ece3400team11/ece3400team11.github.io/_labs/milestone1/milestone1.md

---
layout: subpage
title:  "Milestone1"
---

# Milestone 1

Introduction

## Task 1 - Setting up the Line Sensors:

Demo:

## Task 2 - Following a line autonomously:

Demo:

## Task 3 - Traversing the Grid in a Figure Eight Pattern:

Demo:

## Bloopers :sweat_smile:
