ece3400team11/ece3400team11.github.io/_labs/lab2/images/6khztriangle.png

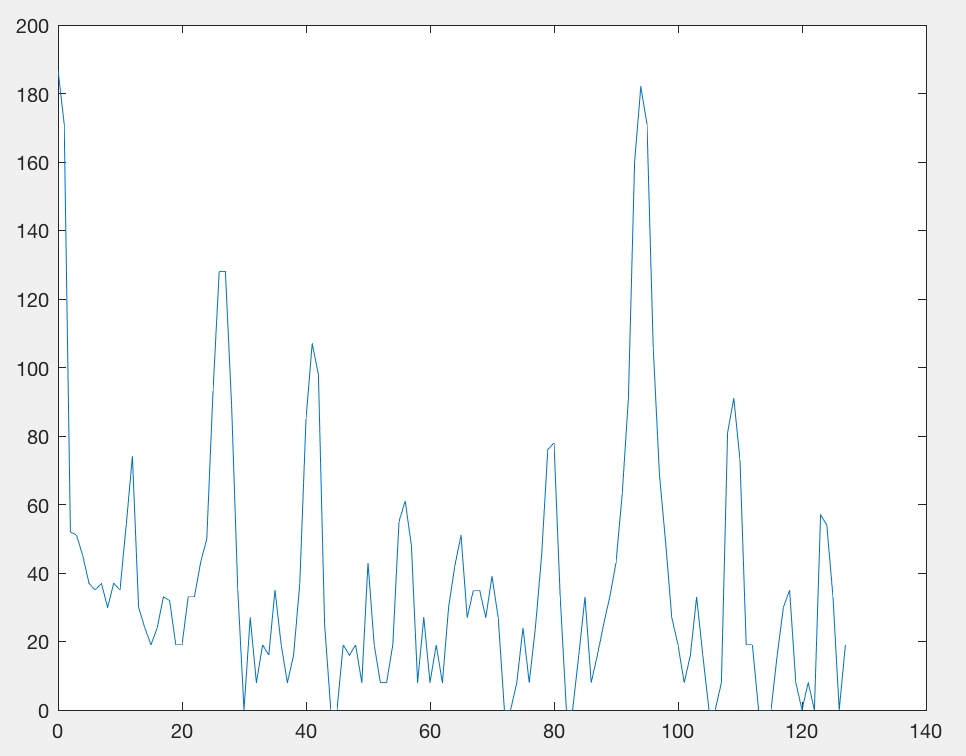
_labs/lab2/images/6khztriangle.png
