ece3400team11/ece3400team11.github.io/_labs/lab2/images/hatwaveform2.jpg

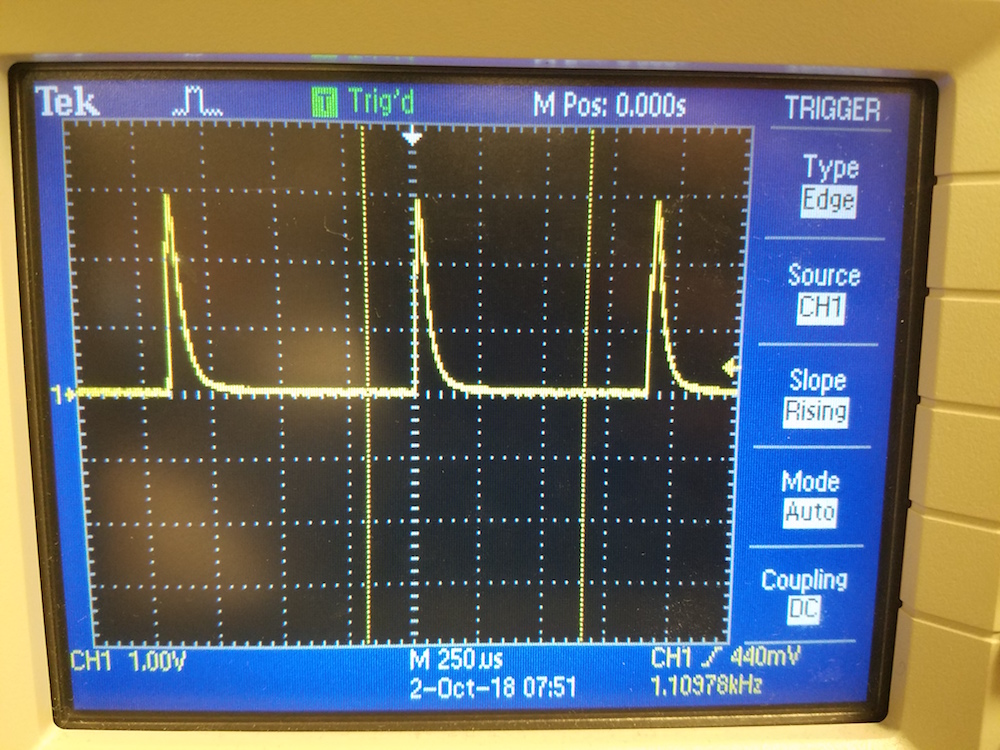
_labs/lab2/images/hatwaveform2.jpg
