ece3400team11/ece3400team11.github.io/_labs/lab2/images/speaker-bgd.png

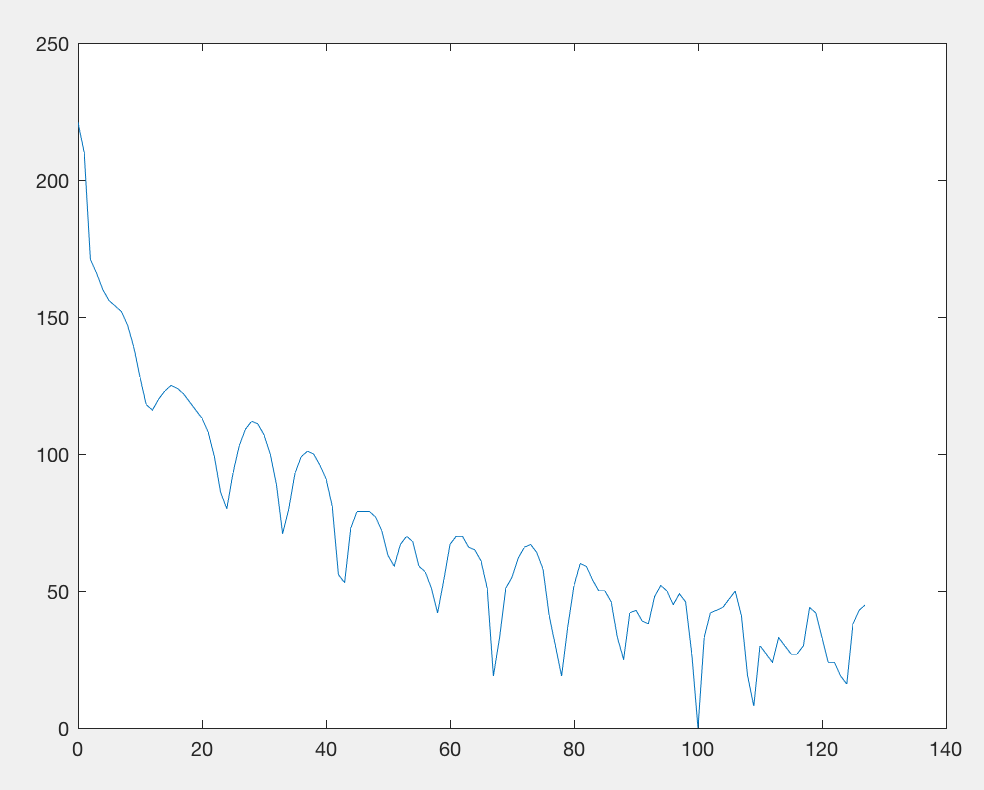
_labs/lab2/images/speaker-bgd.png
