ece3400team11/ece3400team11.github.io/_labs/lab3/images/20181021_163816.jpg

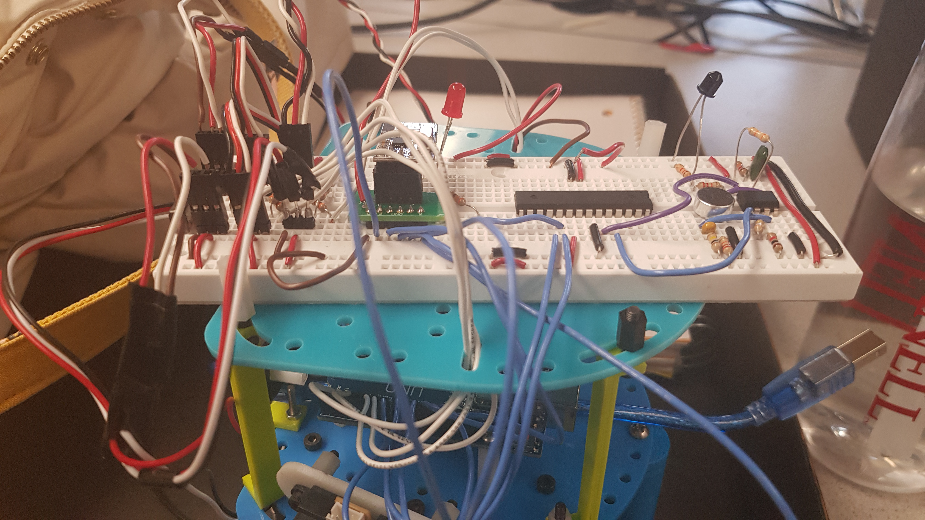
_labs/lab3/images/20181021_163816.jpg
