ece3400team11/ece3400team11.github.io/_labs/lab3/images/Atmega_circuit_2.jpg

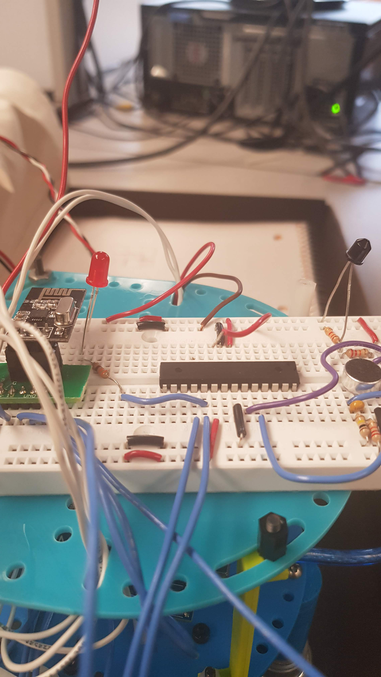
_labs/lab3/images/Atmega_circuit_2.jpg
