ece3400team11/ece3400team11.github.io/_labs/lab3/images/IR_and_Mic_circuit_diagrams.png

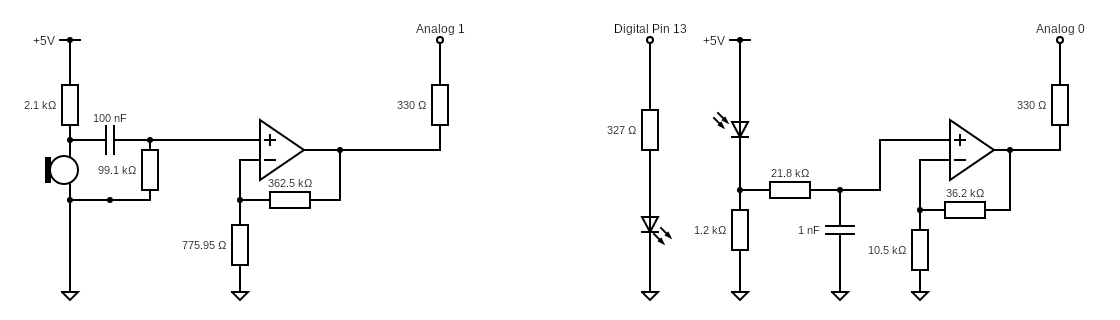
_labs/lab3/images/IR_and_Mic_circuit_diagrams.png
