ece3400team11/ece3400team11.github.io/_labs/lab3/images/IR_and_Mic_circuits_1.jpg

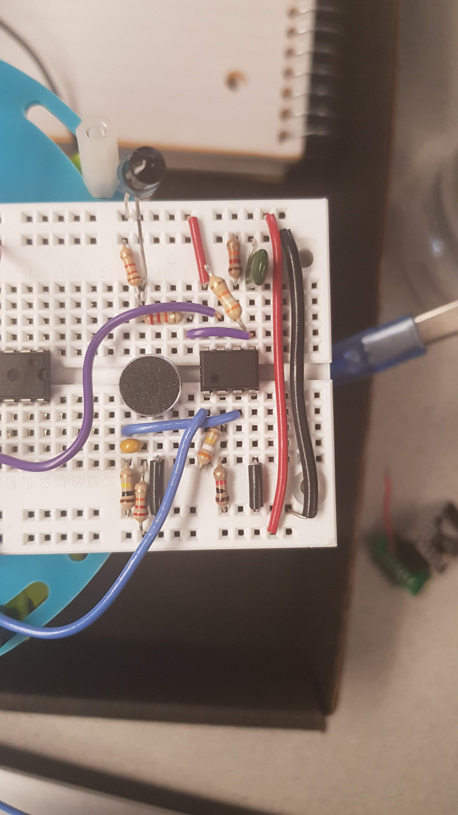
_labs/lab3/images/IR_and_Mic_circuits_1.jpg
