ece3400team11/ece3400team11.github.io/_labs/lab3/images/IR_circuit_diagram.JPG

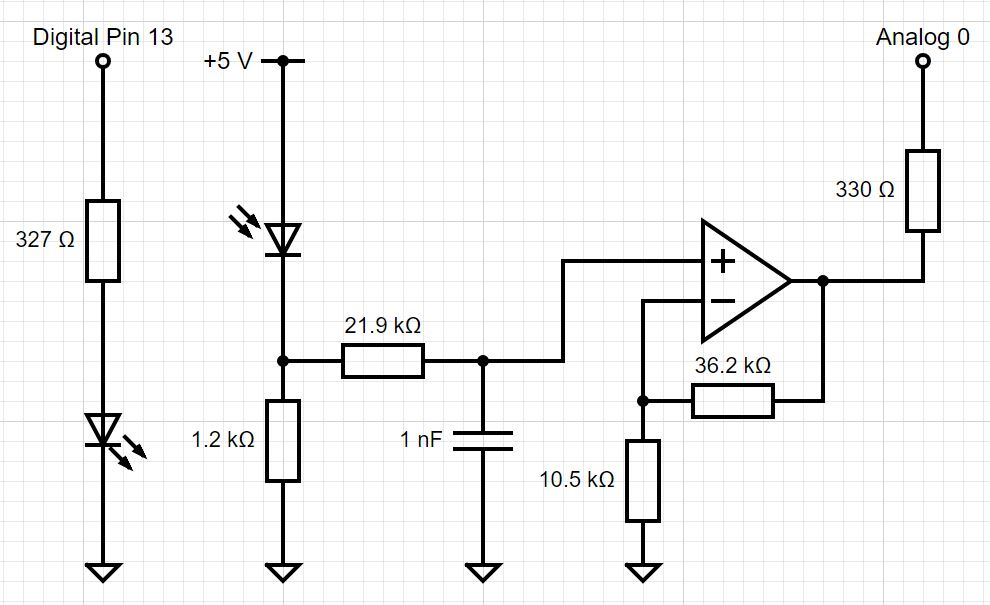
_labs/lab3/images/IR_circuit_diagram.JPG
