ece3400team11/ece3400team11.github.io/_labs/lab3/images/RF_circuit_1.jpg

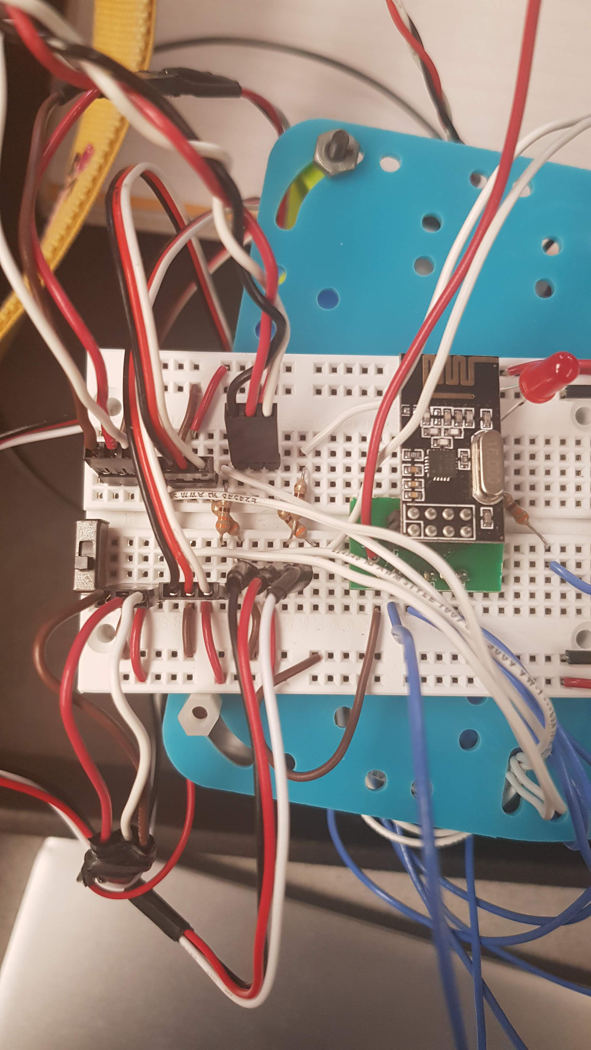
_labs/lab3/images/RF_circuit_1.jpg
