ece3400team11/ece3400team11.github.io/_milestones/milestone1/images/Robot.jpg

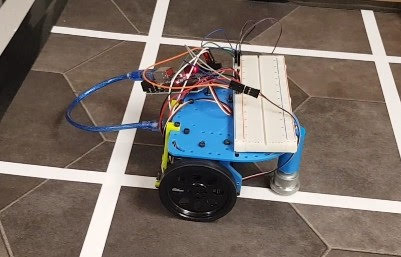
_milestones/milestone1/images/Robot.jpg
