ece3400team11/ece3400team11.github.io/_milestones/milestone2/images/m2_5.jpg

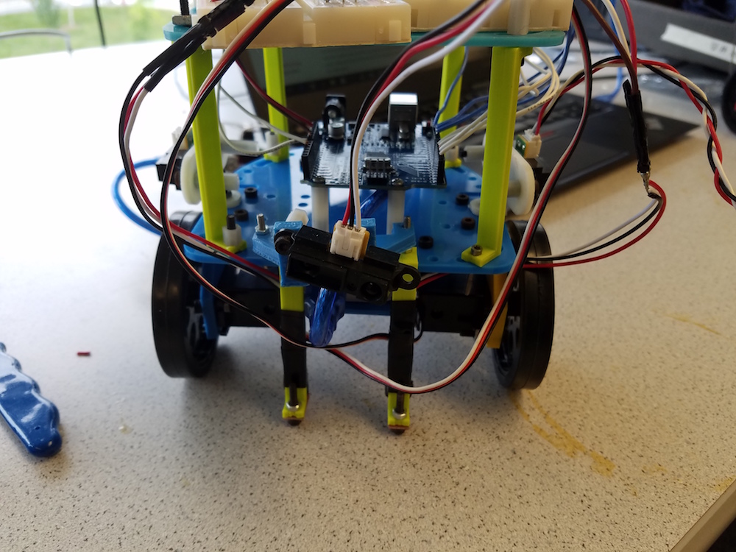
_milestones/milestone2/images/m2_5.jpg
