ece3400team11/ece3400team11.github.io/assets/images/adam.JPG

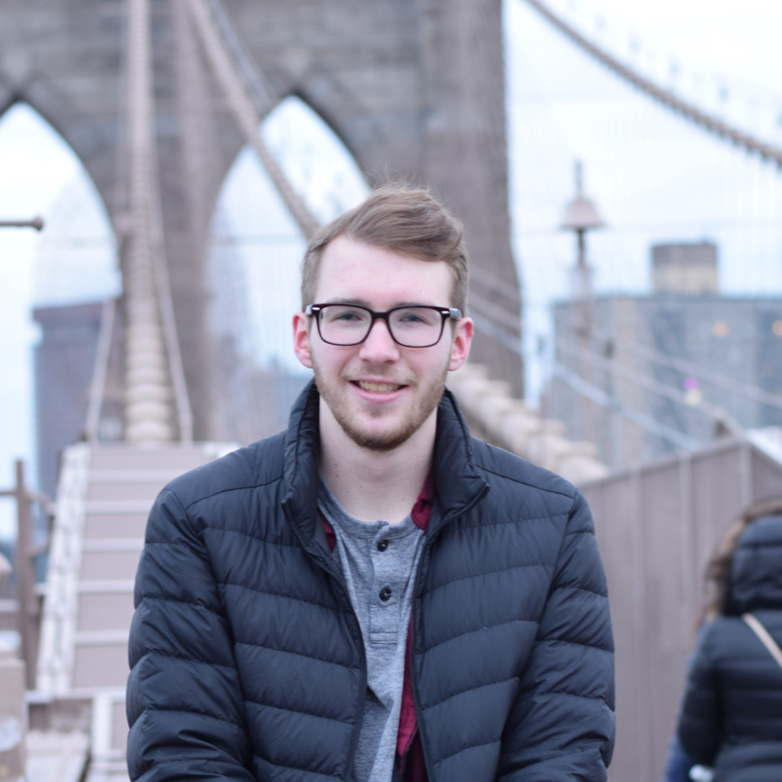
assets/images/adam.JPG
