ece3400team11/ece3400team11.github.io/assets/images/daniel.jpg

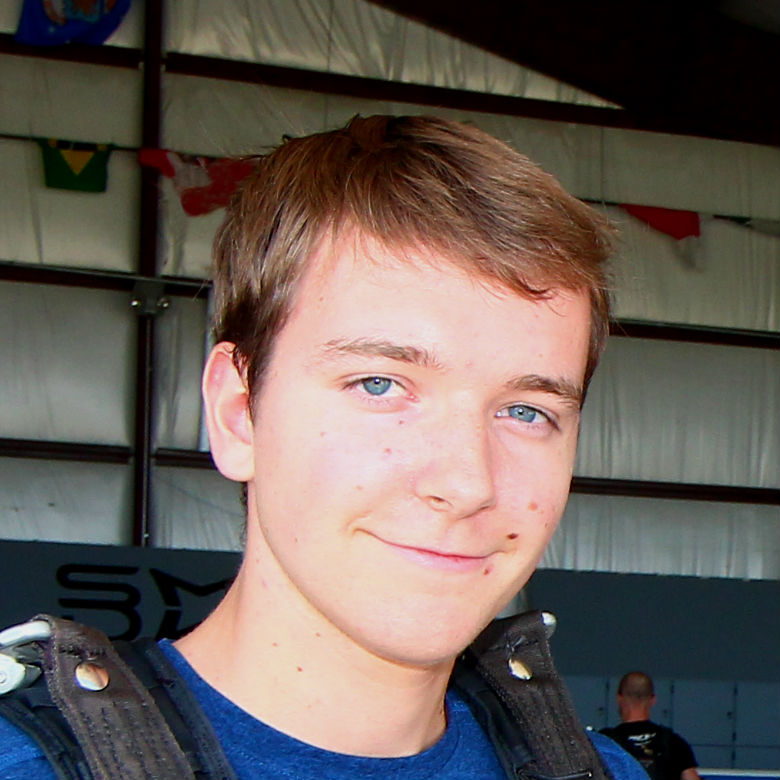
assets/images/daniel.jpg
