ece3400team11/ece3400team11.github.io/assets/images/header.png

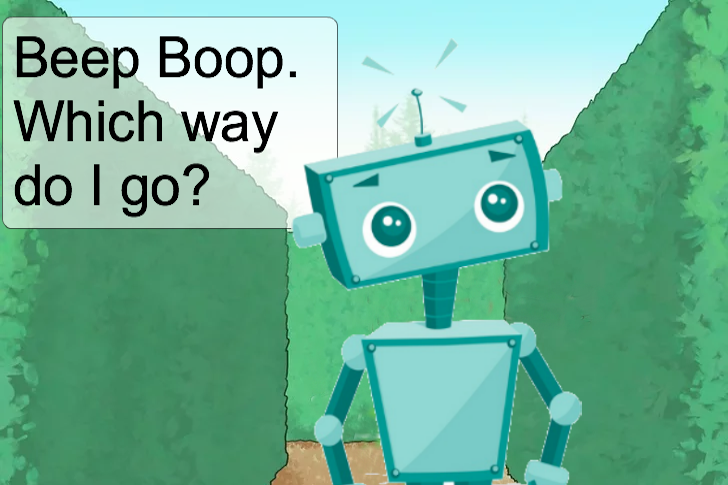
assets/images/header.png
