ece3400team11/ece3400team11.github.io/assets/images/lab1_img.png

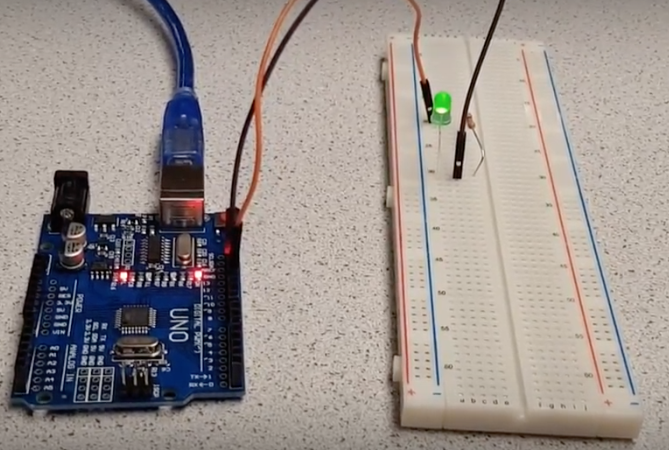
assets/images/lab1_img.png
