ece3400team11/ece3400team11.github.io/assets/images/lab2.png

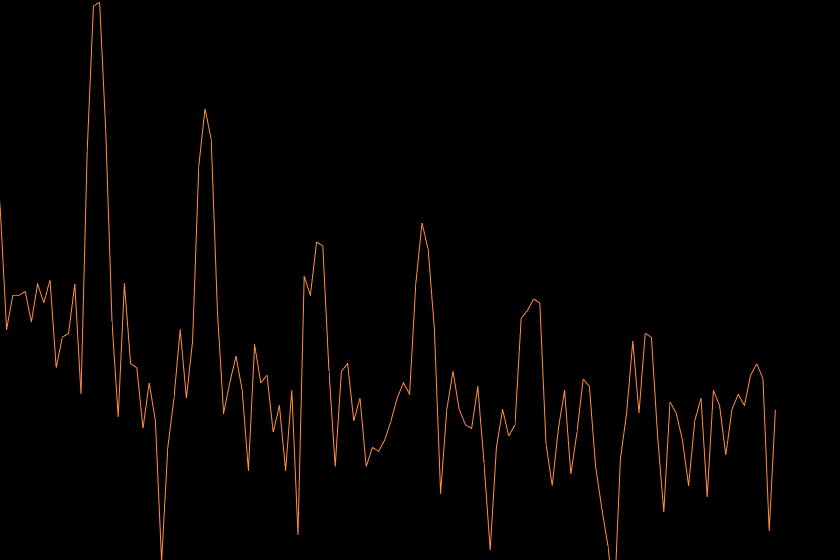
assets/images/lab2.png
