ece3400team11/ece3400team11.github.io/assets/images/lab3.png

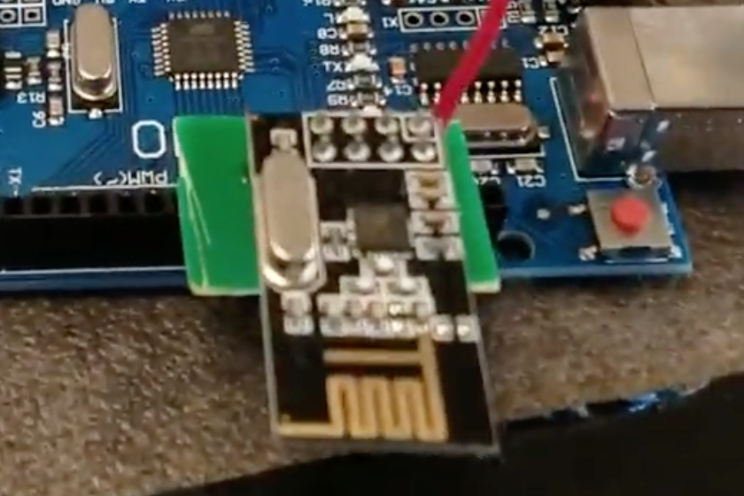
assets/images/lab3.png
