ece3400team11/ece3400team11.github.io/assets/images/lab4.png

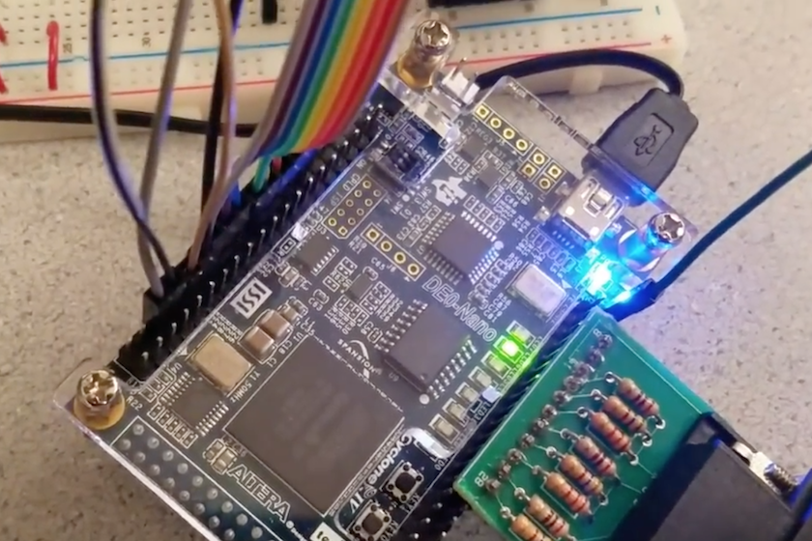
assets/images/lab4.png
