ece3400team11/ece3400team11.github.io/assets/images/Lab-1.png

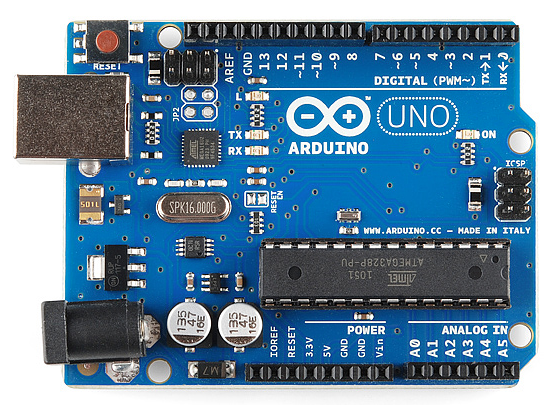
assets/images/Lab-1.png
