ece3400team11/ece3400team11.github.io/assets/images/milestone1.jpg

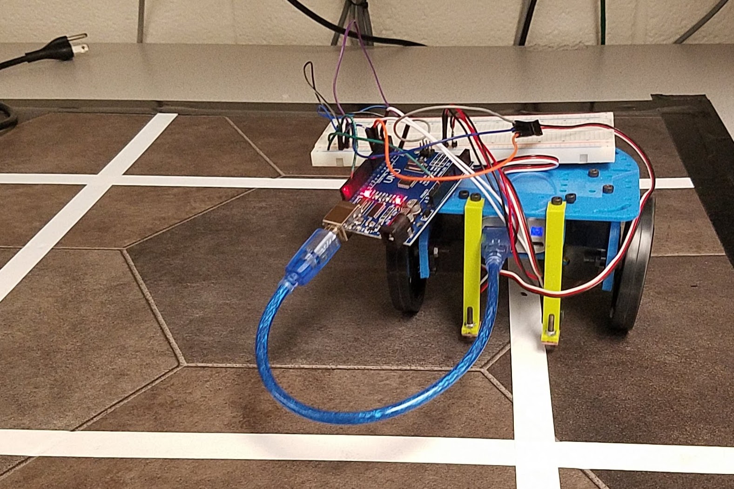
assets/images/milestone1.jpg
