ece3400team11/ece3400team11.github.io/assets/images/milestone3.jpg

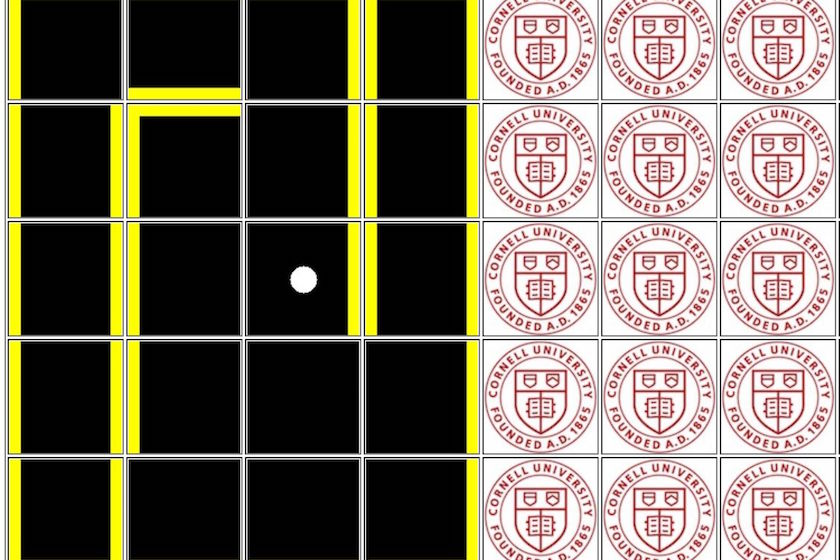
assets/images/milestone3.jpg
