ece3400team11/ece3400team11.github.io/assets/images/ms2.png

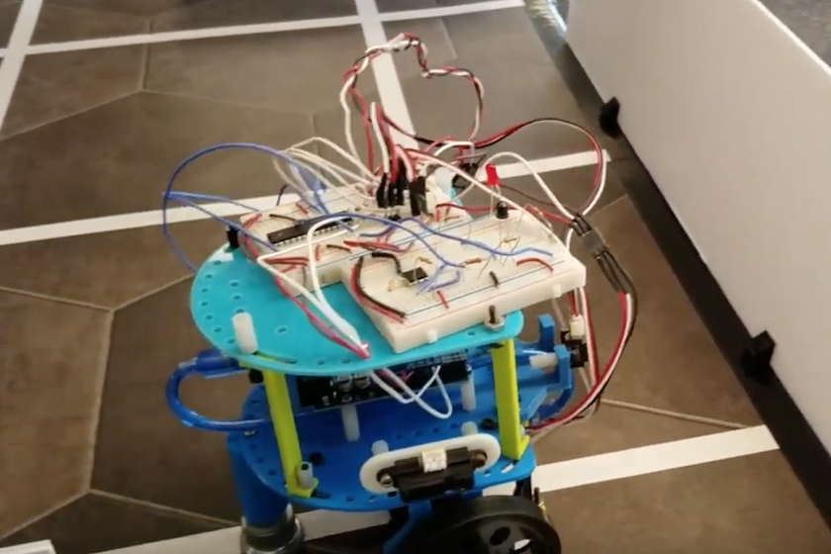
assets/images/ms2.png
