ece3400team11/ece3400team11.github.io/assets/images/ms4.png

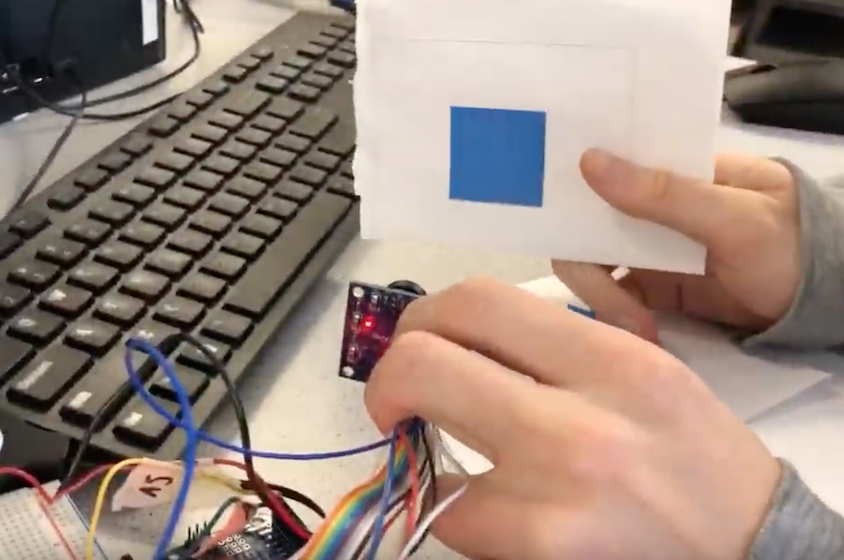
assets/images/ms4.png
