ece3400team11/ece3400team11.github.io/assets/images/Shivy.jpg

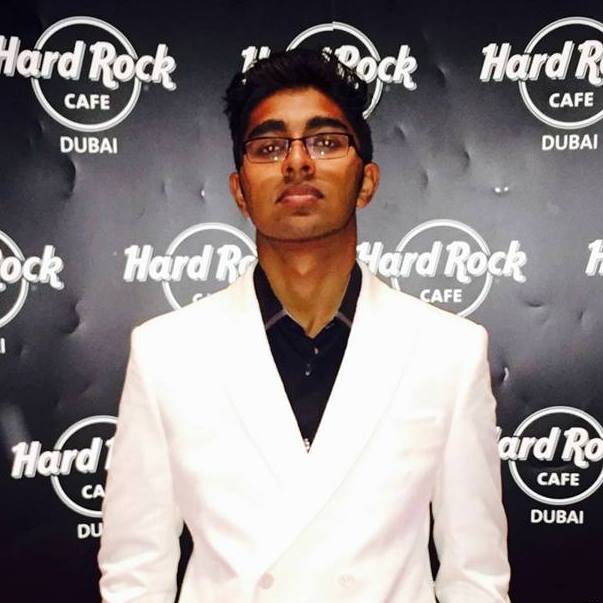
assets/images/Shivy.jpg
