ece3400team11/ece3400team11.github.io/assets/images/Vignesh.jpg

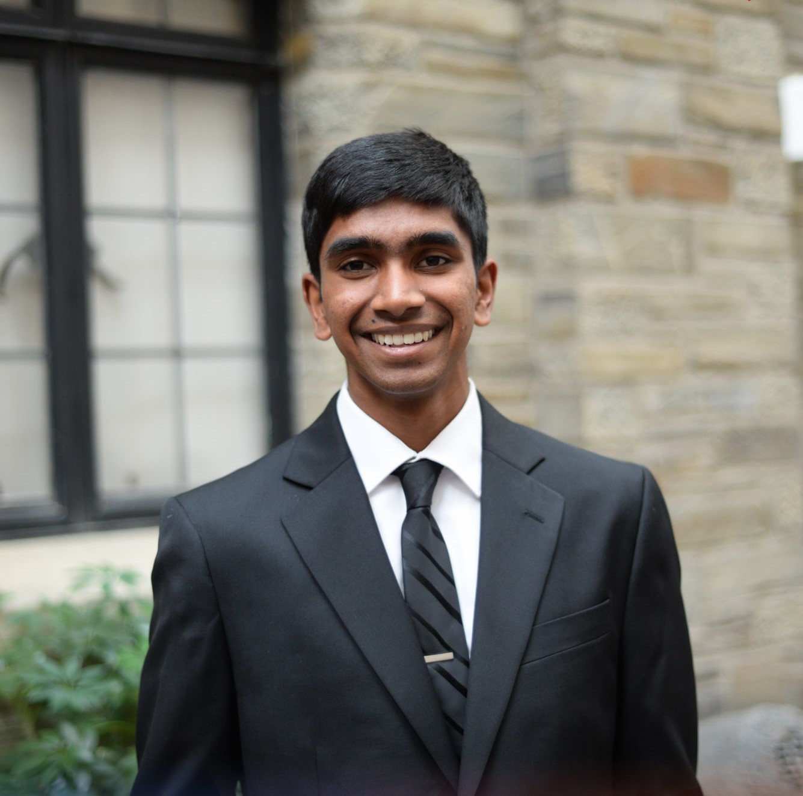
assets/images/Vignesh.jpg
