ece3400team11/ece3400team11.github.io/images/20181201_180837.jpg

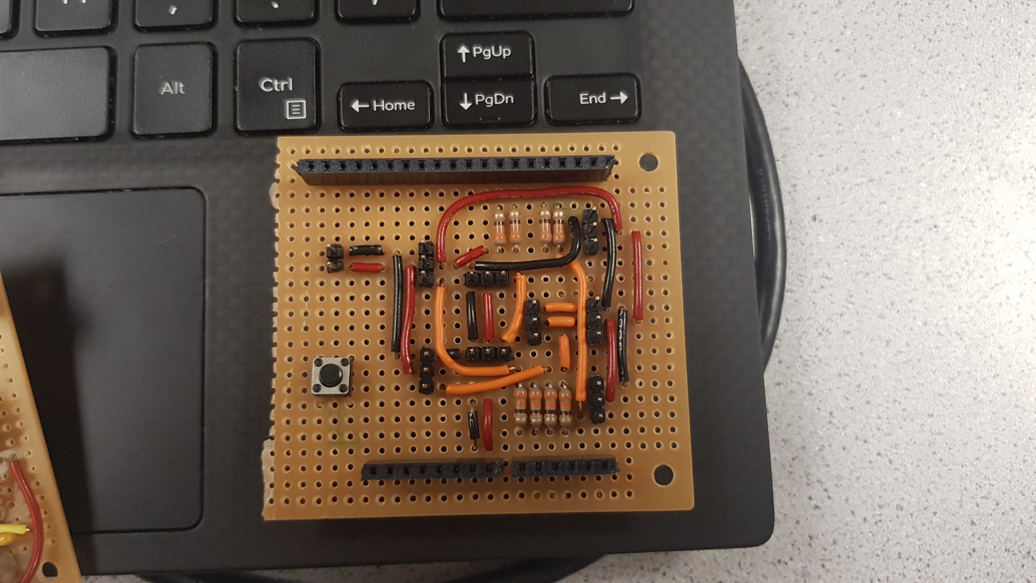
images/20181201_180837.jpg
