ece3400team11/ece3400team11.github.io/images/group.jpg

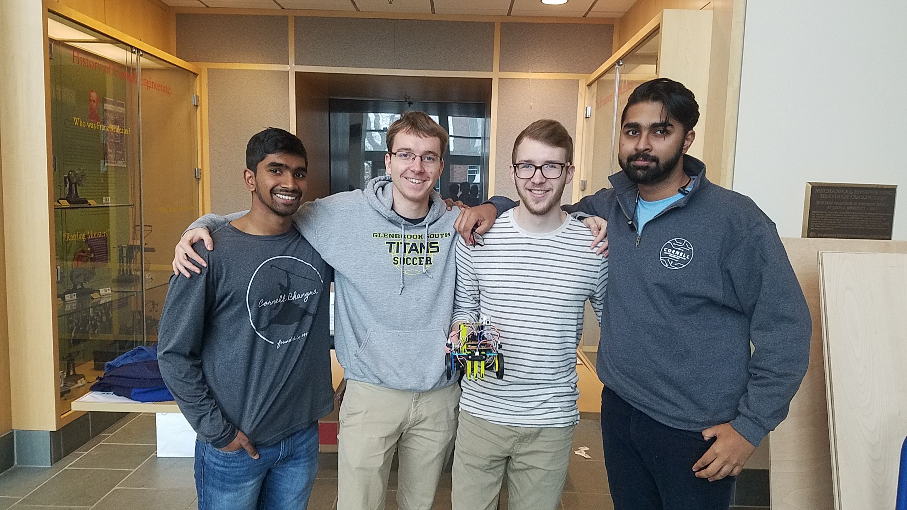
images/group.jpg
