ece3400team11/ece3400team11.github.io/_labs/lab1/code/Blink_v2/Blink_v2.ino

/*
  Blink

  Turns an LED on for one second, then off for one second, repeatedly.

  Most Arduinos have an on-board LED you can control. On the UNO, MEGA and ZERO
  it is attached to digital pin 13, on MKR1000 on pin 6. LED_BUILTIN is set to
  the correct LED pin independent of which board is used.
  If you want to know what pin the on-board LED is connected to on your Arduino
  model, check the Technical Specs of your board at:
  https://www.arduino.cc/en/Main/Products

  modified 8 May 2014
  by Scott Fitzgerald
  modified 2 Sep 2016
  by Arturo Guadalupi
  modified 8 Sep 2016
  by Colby Newman

  This example code is in the public domain.

  http://www.arduino.cc/en/Tutorial/Blink
*/

#define PIN_NUMBER 0
//#define PIN_NUMBER 1
//#define PIN_NUMBER 2
//#define PIN_NUMBER 3
//#define PIN_NUMBER 4
//#define PIN_NUMBER 5
//#define PIN_NUMBER 6
//#define PIN_NUMBER 7
//#define PIN_NUMBER 8
//#define PIN_NUMBER 9
//#define PIN_NUMBER 10
//#define PIN_NUMBER 11
//#define PIN_NUMBER 12
//#define PIN_NUMBER 13

// the setup function runs once when you press reset or power the board
void setup() {
  // initialize digital pin PIN_NUMBER as an output.
  pinMode(PIN_NUMBER, OUTPUT);
}

// the loop function runs over and over again forever
void loop() {
  digitalWrite(PIN_NUMBER, HIGH);   // turn the LED on (HIGH is the voltage level)
  delay(1000);                       // wait for a second
  digitalWrite(PIN_NUMBER, LOW);    // turn the LED off by making the voltage LOW
  delay(1000);                       // wait for a second
}
