ece3400team11/ece3400team11.github.io/(commit log)

2018-09-07 Changed LED_PIN to PIN_NUMBER
2018-09-07 Fixed pin numbering
2018-09-14 Added Line Sensor image
2018-09-28 Added circuit diagram
2018-09-28 Added circuit pic
2018-10-21 Added circuit diagrams and pics
2018-11-29 Edited LED and RESULT code
2018-12-01 added error detection and adjusted thresh
    [maze_explore.ino, sensors.ino, state_mach.ino]
2018-12-01 Changed center sensor to digital
2018-12-06 added camera code
